jorisplusplus/brucon/prelim_bom.ods

 | Pieces | Cost | Total
MT3608L | 1 | 0.0291 | 0.0291
DEALON USB-TYPE-C-018 | 1 | 0.0286 | 0.0286
TC5020D | 6 | 0.0212 | 0.1272
NH-B1212RGBA-HF | 600 | 0.0037 | 2.22
SC7A20TR | 1 | 0.01935 | 0.01935
HC-PJ-320D | 1 | 0.0242 | 0.0242
TC7262C | 3 | 0.0485 | 0.1455
XR0630-4R7M | 1 | 0.0308 | 0.0308
sk-3296s | 1 | 0.0266 | 0.0266
TP4056-MS | 1 | 0.0372 | 0.0372
HT7533-1 | 1 | 0.0199 | 0.0199
Resistors/Caps | 1 | 0.15 | 0.15
WTB01W03BB | 1 | 0.0138 | 0.0138
ESP32-S2-MINI-2-N4 | 1 | 2.0396 | 2.0396
74HCT245 | 1 | 0.066 | 0.066
 |  |  | 0
 |  |  | 0
 |  |  | 0
 |  |  | 0
 |  |  | 0
 |  |  | 0
 |  |  | 0
 |  |  | 4.97785
 |  | Budget | 5
 |  | Remain | 0.0221499999999999
