jorisplusplus/brucon/brucon_hardware/production/bom_norbert.csv

Reference | Value | Datasheet | Footprint | Qty | DNP | LCSC
C1,C2,C3 | 10uF | ~ | Capacitor_SMD:C_0603_1608Metric | 3 |  | C6119842
C101,C202,C203,C204,C206 | 22uF | ~ | Capacitor_SMD:C_0805_2012Metric | 5 |  | C45783
C102,C103,C104,C105,C106,C107,C108,C109,C301,C302,C303,C304,C305,C306,C307,C308,C309 | 100nF | ~ | Capacitor_SMD:C_0603_1608Metric | 17 |  | C14663
D201,D202 | Red LED | https://www.lcsc.com/datasheet/lcsc_datasheet_2304140030_Foshan-NationStar-Optoelectronics-NCD0805R1_C84256.pdf | LED_SMD:LED_0805_2012Metric | 2 |  | C84256
D401,D402,D403,D404,D405,D406,D407,D408,D409,D410,D411,D412,D413,D414,D415,D416,D417,D418,D419,D501,D502,D503,D504,D505,D506,D507,D508,D509,D510,D511,D512,D513,D514,D515,D516,D517,D518,D519,D601,D602,D603,D604,D605,D606,D607,D608,D609,D610,D611,D612,D613,D614,D615,D616,D617,D618,D619,D701,D702,D703,D704,D705,D706,D707,D708,D709,D710,D711,D712,D713,D714,D715,D716,D717,D718,D719,D801,D802,D803,D804,D805,D806,D807,D808,D809,D810,D811,D812,D813,D814,D815,D816,D817,D818,D819,D901,D902,D903,D904,D905,D906,D907,D908,D909,D910,D911,D912,D913,D914,D915,D916,D917,D918,D919,D1001,D1002,D1003,D1004,D1005,D1006,D1007,D1008,D1009,D1010,D1011,D1012,D1013,D1014,D1015,D1016,D1017,D1018,D1019,D1101,D1102,D1103,D1104,D1105,D1106,D1107,D1108,D1109,D1110,D1111,D1112,D1113,D1114,D1115,D1116,D1117,D1118,D1119,D1201,D1202,D1203,D1204,D1205,D1206,D1207,D1208,D1209,D1210,D1211,D1212,D1213,D1214,D1215,D1216,D1217,D1218,D1219,D1301,D1302,D1303,D1304,D1305,D1306,D1307,D1308,D1309,D1310,D1311,D1312,D1313,D1314,D1315,D1316,D1317,D1318,D1319,D1401,D1402,D1403,D1404,D1405,D1406,D1407,D1408,D1409,D1410,D1411,D1412,D1413,D1414,D1415,D1416,D1417,D1418,D1419,D1501,D1502,D1503,D1504,D1505,D1506,D1507,D1508,D1509,D1510,D1511,D1512,D1513,D1514,D1515,D1516,D1517,D1518,D1519,D1601,D1602,D1603,D1604,D1605,D1606,D1607,D1608,D1609,D1610,D1611,D1612,D1613,D1614,D1615,D1616,D1617,D1618,D1619,D1701,D1702,D1703,D1704,D1705,D1706,D1707,D1708,D1709,D1710,D1711,D1712,D1713,D1714,D1715,D1716,D1717,D1718,D1719,D1801,D1802,D180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 | NH-B1212RGBA-HF | https://www.lcsc.com/datasheet/lcsc_datasheet_2108150330_Foshan-NationStar-Optoelectronics-NH-B1212RGBA-HF_C2874114.pdf | NH-B1212RGBA:NH-B1212RGBA | 608 |  | C2874114
J101 | PJ-320D | https://www.lcsc.com/datasheet/lcsc_datasheet_2406051353_HanElectricity-PJ-320D_C22459515.pdf | Connector_Audio:Jack_3.5mm_KoreanHropartsElec_PJ-320D-4A_Horizontal | 1 |  | C22459515
J102 | USB-TYPE-C-018 | https://www.lcsc.com/datasheet/lcsc_datasheet_2201121330_DEALON-USB-TYPE-C-018_C2927038.pdf | Connector_USB:USB_C_Receptacle_HRO_TYPE-C-31-M-12 | 1 |  | C2927038
J201 | WTB01W03BB | https://www.lcsc.com/datasheet/lcsc_datasheet_2207191430_BZCN-WTB01W03BB_C3036372.pdf | Connector_JST:JST_SH_SM03B-SRSS-TB_1x03-1MP_P1.00mm_Horizontal | 1 |  | C3036372
L201 | 2.2uH | https://www.lcsc.com/datasheet/lcsc_datasheet_2309011029_Ceaiya-CR5030-2R2M_C7588710.pdf | Inductor_SMD:L_Changjiang_FNR5030S | 1 |  | C7588710
Q1,Q2 | AO3400A | http://www.aosmd.com/pdfs/datasheet/AO3400A.pdf | Package_TO_SOT_SMD:SOT-23 | 2 |  | C347475
R1 | 2 | ~ | Resistor_SMD:R_0402_1005Metric | 1 |  | C270630
R2,R6 | 10k | ~ | Resistor_SMD:R_0402_1005Metric | 2 |  | C25744
R3,R7,R101,R103,R108,R109,R110,R111,R112,R113 | 1k | ~ | Resistor_SMD:R_0402_1005Metric | 10 |  | C11702
R5,R102 | 10 | ~ | Resistor_SMD:R_0402_1005Metric | 2 |  | C25077
R104,R105,R106,R107 | 5.1k | ~ | Resistor_SMD:R_0402_1005Metric | 4 |  | C25905
R203,R204 | 200 | ~ | Resistor_SMD:R_0402_1005Metric | 2 |  | C25087
R301,R302,R303,R304,R305,R306 | 1.8k | ~ | Resistor_SMD:R_0402_1005Metric | 6 |  | C25871
SW1 | TSB008A2530A | https://www.lcsc.com/datasheet/lcsc_datasheet_2109061830_BZCN-TSB008A2530A_C2888954.pdf | Button:SW_SPST | 1 |  | C2888954
SW101,SW102,SW103,SW104,SW105,SW106 | B3FS-1010P | https://omronfs.omron.com/en_US/ecb/products/pdf/en-b3fs.pdf | Button:SW_Push_1P1T_NO_6x6mm_H9.5mm | 6 |  | C22375334
U1 | IP5305T | https://www.lcsc.com/datasheet/lcsc_datasheet_2311011131_INJOINIC-IP5305T_C2982924.pdf | Package_SO:HSOP-8-1EP_3.9x4.9mm_P1.27mm_EP2.41x3.1mm_ThermalVias | 1 |  | C2982924
U101 | ESP32-S2-MINI-2-N4 | https://www.lcsc.com/datasheet/lcsc_datasheet_2208151830_Espressif-Systems-ESP32-S2-MINI-2-N4_C3013906.pdf | PCM_Espressif:ESP32-S2-MINI-2 | 1 |  | C3013906
U102 | SC7A20TR | https://www.lcsc.com/datasheet/lcsc_datasheet_2403271435_Hangzhou-Silan-Microelectronics-SC7A20TR_C5126709.pdf | Package_LGA:LGA-12_2x2mm_P0.5mm | 1 |  | C5126709
U203 | HT75xx-1-SOT89 | https://www.holtek.com/documents/10179/116711/HT75xx-1v250.pdf | Package_TO_SOT_SMD:SOT-89-3 | 1 |  | C499633
U301 | 74HCT245PW | https://www.lcsc.com/datasheet/lcsc_datasheet_2304140030_Nexperia-74HCT245PW-118_C5980.pdf | Package_SO:TSSOP-20_4.4x6.5mm_P0.65mm | 1 |  | C5980
U302,U303,U304 | TC7262C | http://www.superchip.cn/Private/ProductFiles/6364584403048069321406626239.pdf | Package_SO:SO-16_3.9x9.9mm_P1.27mm | 3 |  | C2887471
U305,U306,U307,U308,U309,U310 | TC5020D | https://datasheet.lcsc.com/szlcsc/Shenzhen-Mingwei-Elec-SM16106SC_C121618.pdf | Package_SO:SSOP-24_3.9x8.7mm_P0.635mm | 6 |  | C18221482
