jorisplusplus/brucon/(commit log)

2024-04-03 Added prelim bom
    [prelim_bom.ods]
2024-04-03 Rough schematic draft
    [brucon_hardware.kicad_pcb, brucon_hardware.kicad_sch, ledmatrix.kicad_sch, power.kicad_sch]
2024-05-23 Updated led matrix
    [brucon_hardware.kicad_pcb, brucon_hardware.kicad_sch, ledmatrix.kicad_sch, power.kicad_sch, row.kicad_sch]
2024-05-23 Updated bom
    [brucon_hardware.kicad_sch, ledmatrix.kicad_sch, power.kicad_sch, row.kicad_sch]
2024-05-24 Initial led matrix placement
    [brucon_hardware.kicad_pcb, ledmatrix.kicad_sch, row.kicad_sch]
2024-05-25 Finished major parts routing led matrix
    [brucon_hardware.kicad_pcb, brucon_hardware.kicad_sch, ledmatrix.kicad_sch, power.kicad_sch, row.kicad_sch]
2024-05-26 Major parts routed
    [brucon_hardware.kicad_sch, ledmatrix.kicad_sch, power.kicad_sch]
2024-05-26 Finished routing
    [brucon_hardware.kicad_sch]
2024-05-30 Fixed gpio strapping pin
    [brucon_hardware.kicad_sch]
2024-06-12 Updated to kicad v8
    [brucon_hardware.kicad_sch, ledmatrix.kicad_sch, power.kicad_sch, row.kicad_sch]
2024-06-15 Fixed DRC errors
    [brucon_hardware.kicad_sch, row.kicad_sch]
2024-07-04 As of prototype 1
    [bom.csv, brucon_hardware.kicad_sch, designators.csv, ledmatrix.kicad_sch, positions.csv, power.kicad_sch, row.kicad_sch]
2024-07-13 Updated hardware
    [brucon_hardware.kicad_sch, ledmatrix.kicad_sch, power.kicad_sch, row.kicad_sch]
2024-07-20 Updated part numbers
    [brucon_hardware.kicad_sch, ledmatrix.kicad_sch, power.kicad_sch, row.kicad_sch]
2024-07-21 Small changes
    [brucon_hardware.kicad_sch, ledmatrix.kicad_sch, power.kicad_sch]
2024-07-21 Changed jack
    [brucon_hardware.kicad_sch]
2024-07-21 Added datasheet URLs for BoM, moved INT1 trace further away from board outline
    [brucon_hardware.kicad_sch, ledmatrix.kicad_sch, power.kicad_sch, row.kicad_sch]
2024-07-21 Swapped IP5305 for IP5305T (needs current limiting resistors on LEDs), swapped buffer for Nexperia alternative for availability and price. Ordered 2nd prototype.
    [bom.csv, brucon_hardware.kicad_sch, designators.csv, ledmatrix.kicad_sch, positions.csv, power.kicad_sch]
2024-07-21 Fixed value and datasheet for bootmode switch
    [brucon_hardware.kicad_sch]
2024-08-19 Committing final hardware as has been produced
    [bom.csv, bom_norbert.csv, designators.csv, positions_norbert.csv, power.kicad_sch]
